SCUT-RobotIC/IR_Communication/Core/Src/main.c

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
/* Includes ------------------------------------------------------------------*/
#include "main.h"
#include "can.h"
#include "tim.h"
#include "usart.h"
#include "gpio.h"

/* USER CODE BEGIN Includes */
#include "IR.h"
#include "string.h"
/* USER CODE END Includes */


/* USER CODE BEGIN PV */
ir_data_t ir_data;
int16_t watch[5]={0};
extern uint8_t try[20];
//0-cnt_rx
/* USER CODE END PV */

void SystemClock_Config(void);
/**
  * @brief  The application entry point.
  * @retval int
  */
int main(void)
{

  /* MCU Configuration--------------------------------------------------------*/

  /* Reset of all peripherals, Initializes the Flash interface and the Systick. */
  HAL_Init();

  /* Configure the system clock */
  SystemClock_Config();

  /* Initialize all configured peripherals */
  MX_GPIO_Init();
  MX_CAN_Init();
  MX_TIM2_Init();
  MX_TIM3_Init();
  MX_USART1_UART_Init();
  /* USER CODE BEGIN 2 */
	HAL_TIM_Base_Start_IT(&htim2);
	HAL_TIM_Base_Start_IT(&htim3);
	memcpy(ir_data.data_tx,try,20);
	HAL_GPIO_WritePin(ir_power_port,ir_power_pin,1);
  /* USER CODE END 2 */

  /* Infinite loop */
  /* USER CODE BEGIN WHILE */
  while (1)
  {
    /* USER CODE END WHILE */

    /* USER CODE BEGIN 3 */
  }
  /* USER CODE END 3 */
}

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
/* USER CODE BEGIN 4 */

void HAL_GPIO_EXTI_Callback(uint16_t GPIO_Pin) {
    if (GPIO_Pin == GPIO_PIN_1) {
        if(HAL_GPIO_ReadPin(ir_input_port, ir_input_pin) == GPIO_PIN_RESET){
						HAL_GPIO_WritePin(ir_input_flag_port,ir_input_flag_pin,1);//指示灯
            if(ir_data.cnt_rx >= ir_period_one-1 & ir_data.cnt_rx <= ir_period_one+1){
                ir_data.data_rx[ir_data.ptr_rx/8] |= (1 << (ir_data.ptr_rx%8));
            }
            else if(ir_data.cnt_rx >= ir_period_zero-1 & ir_data.cnt_rx <= ir_period_zero+1){
                ir_data.data_rx[ir_data.ptr_rx/8] &= ~(1 << (ir_data.ptr_rx%8));
            }
            if(ir_data.ptr_rx<8*ir_data_len){  
                ir_data.ptr_rx++;
            }
            else{   
                ir_data.ptr_rx=0;
            }
            ir_data.flag_rx=IR_rx_done;
        }
        else{//(HAL_GPIO_ReadPin(ir_input_port, ir_input_pin) == GPIO_PIN_SET)
						HAL_GPIO_WritePin(ir_input_flag_port,ir_input_flag_pin,0);
            ir_data.flag_rx=IR_rx_receiving;
        }
        ir_data.cnt_rx=0;
    }
}

/* USER CODE END 4 */

/**
  * @brief  Period elapsed callback in non blocking mode
  * @note   This function is called  when TIM1 interrupt took place, inside
  * HAL_TIM_IRQHandler(). It makes a direct call to HAL_IncTick() to increment
  * a global variable "uwTick" used as application time base.
  * @param  htim : TIM handle
  * @retval None
  */
void HAL_TIM_PeriodElapsedCallback(TIM_HandleTypeDef *htim)
{
  if (htim->Instance == TIM1) {
    HAL_IncTick();
  }
  /* USER CODE BEGIN Callback 1 */
	if(htim->Instance == TIM2){

		if(ir_data.flag_tx!=IR_tx_transmiting){
			IR_data_upload(try);
		}
    IR_step();
	}
  /* USER CODE END Callback 1 */
}

/**
  * @brief  This function is executed in case of error occurrence.
  * @retval None
  */
void Error_Handler(void)
{
  /* USER CODE BEGIN Error_Handler_Debug */
  /* User can add his own implementation to report the HAL error return state */
  __disable_irq();
  watch[1]=1145;
  while (1)
  {
  }
  /* USER CODE END Error_Handler_Debug */
}

#ifdef  USE_FULL_ASSERT
/**
  * @brief  Reports the name of the source file and the source line number
  *         where the assert_param error has occurred.
  * @param  file: pointer to the source file name
  * @param  line: assert_param error line source number
  * @retval None
  */
void assert_failed(uint8_t *file, uint32_t line)
{
  /* USER CODE BEGIN 6 */
  /* User can add his own implementation to report the file name and line number,
     ex: printf("Wrong parameters value: file %s on line %d\r\n", file, line) */
  /* USER CODE END 6 */
}
#endif /* USE_FULL_ASSERT */
